jcdtech/tw_fancontrol/README.md

# TW Fan Control
Two/Three-Wire Fan Controller
