jcdtech/tw_fancontrol/(list of files, drawings)

Other design files:
fancontrol_kicad/fancontrol.dsn
