jcdtech/tw_fancontrol/fancontrol_kicad/fancontrol.kicad_pcb

## KiCad design fancontrol_kicad/fancontrol.kicad_pcb (2016-10-13)

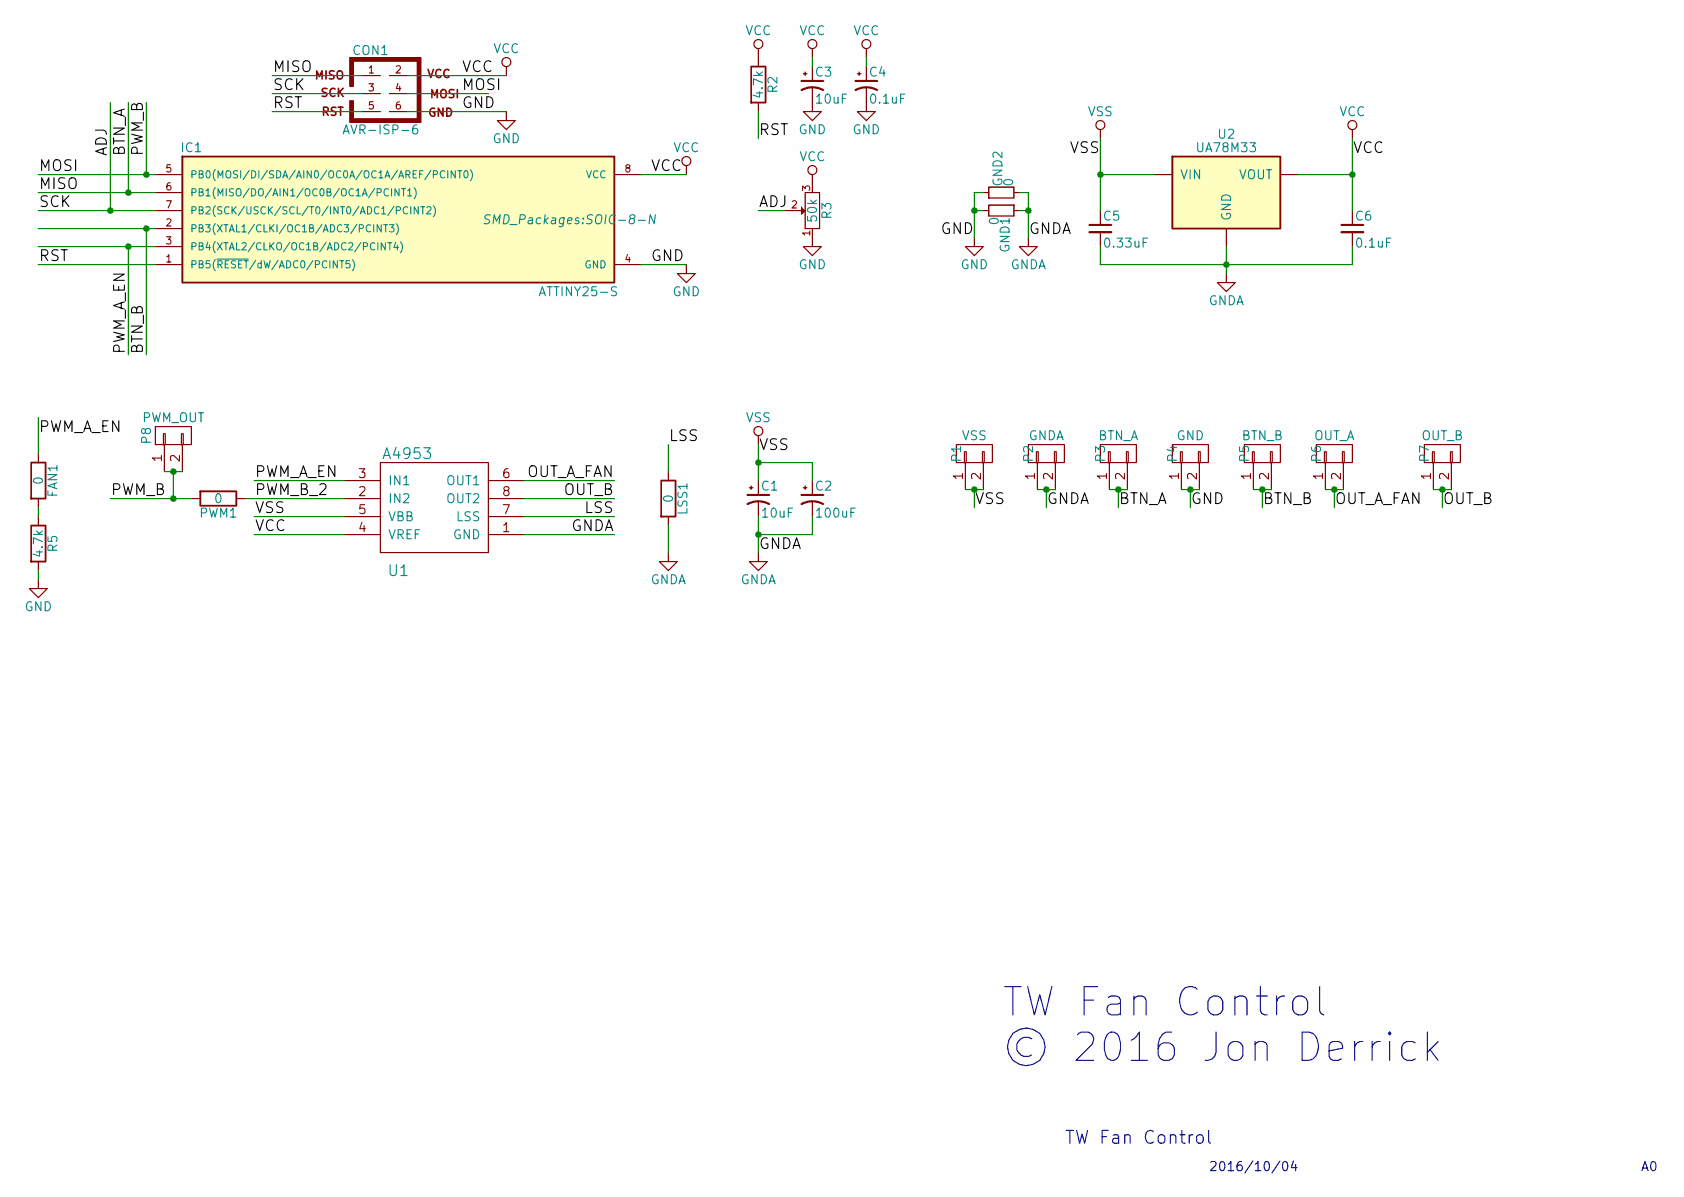
[picture p1: schematic fancontrol.sch]

Parts:
C1, C3: 10uF; TantalC_SizeA_EIA-3216_HandSoldering
C2: 100uF; c_elec_6.3x5.8
C4, C6: 0.1uF; C_0805_HandSoldering
C5: 0.33uF; C_0805_HandSoldering
CON1: AVR-ISP-6; Pin_Header_Straight_2x03
FAN1: 0; GS2
GND1, GND2: 0; GS2
IC1: ATTINY25-S; SOIC-8-N
LSS1: 0; R_0603_HandSoldering
P1: VSS; RIGHT_TERM
P2: GNDA; RIGHT_TERM
P3: BTN_A; RIGHT_TERM
P4: GND; RIGHT_TERM
P5: BTN_B; RIGHT_TERM
P6: OUT_A; RIGHT_TERM
P7: OUT_B; RIGHT_TERM
P8: PWM_OUT; RIGHT_TERM
PWM1: 0; GS2
R2, R5: 4.7k; R_0805_HandSoldering
R3: 50k; POT_SMD
U1: A4953; SOIC-8-N-PAD
U2: UA78M33; SOT-223

Connections:
/ADJ: CON1.3, IC1.7 (PB2(SCK/USCK/SCL/T0/INT0/ADC1/PCINT2)), R3.2
/BTN_A: CON1.1, IC1.6 (PB1(MISO/DO/AIN1/OC0B/OC1A/PCINT1)), P3.1, P3.2
/BTN_B: IC1.2 (PB3(XTAL1/CLKI/OC1B/ADC3/PCINT3)), P5.1, P5.2
/LSS: LSS1.1, U1.7 (LSS)
/MOSI: CON1.4, IC1.5 (PB0(MOSI/DI/SDA/AIN0/OC0A/OC1A/AREF/PCI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), P8.1, P8.2, PWM1.2
/OUT_A_FAN: P6.1, P6.2, U1.6 (OUT1)
/OUT_B: P7.1, P7.2, U1.8 (OUT2)
/PWM_A_EN: FAN1.1, IC1.3 (PB4(XTAL2/CLKO/OC1B/ADC2/PCINT4)), U1.3 (IN1)
/PWM_B_2: PWM1.1, U1.2 (IN2)
/RST: CON1.5, IC1.1 (PB5(~RESET~/dW/ADC0/PCINT5)), R2.2
GND: C3.2, C4.2, CON1.6, GND1.2, GND2.1, IC1.4 (GND), P4.1, P4.2, R3.1, R5.2
GNDA: C1.2, C2.2, C5.2, C6.2, GND1.1, GND2.2, LSS1.2, P2.1, P2.2, U1.1 (GND), U2.2 (GND), U2.4 (GND)
unnamed: FAN1.2, R5.1
VCC: C3.1, C4.1, C6.1, CON1.2, IC1.8 (VCC), R2.1, R3.3, U1.4 (VREF), U2.3 (VOUT)
VSS: C1.1, C2.1, C5.1, P1.1, P1.2, U1.5 (VBB), U2.1 (VIN)

Notes on the sheet:
TW Fan Control
2016/10/04
TW Fan Control © 2016 Jon Derrick

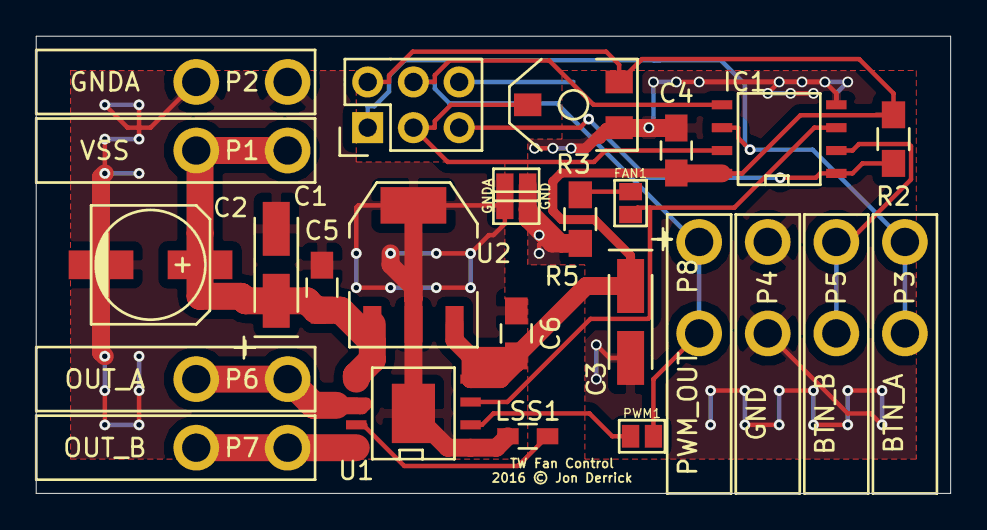
[picture p2: board fancontrol.kicad_pcb from above]

Board: 2 copper layers, 50.8 x 25.4 mm, 26 parts (0 on the bottom side), 15 nets.
