jcdtech/tw_fancontrol/(commit log)

2016-10-13 First commit.
    Tested on breadboard with active-low LED.
2016-10-13 General cleanup.
    Added individual PWM active high knobs and several comments.
    Staged ADC factor code.
2016-10-13 Added ADC initialization and polling code.
    Untested
2016-10-13 Corrected for new pinout using FWD:Counter 1, REV:Counter 0
    Added stubs and comments for MODE selection
    [tw_fancontrol.c]
2016-10-13 First Schematic and PCB Commit
    v1 design
    [fancontrol.dsn, fancontrol.kicad_pcb, fancontrol.sch]
2016-10-13 Added functionality for two/three wire modes
    Detecting the mode is next!
2016-10-23 First prototype
    Fixed several wrong assumptions about sleep mode.
    Fixed a few other logic bugs and incorrect register assignments.
    Changed MODE adc thresh to 1/2 VCC. With 4.7K to ground and a 10k
    pullup, it should read about 1/3 VCC.
    Tested both Two and Three wire mode with 12V VSS.
    [tw_fancontrol.c]
