jcdtech/tw_fancontrol/(notices)

Notices in the files:
tw_fancontrol.c:
This program is free software; you can redistribute it and/or modify
it under the terms of the GNU General Public License as published by
the Free Software Foundation; either version 2 of the License, or (at
fancontrol_kicad/fancontrol.kicad_pcb:
2016 © Jon Derrick
